jahjunn/esp32-micro-drone/docs/WORKPLAN.md

# 轻量无人机飞控 —— 工作计划（WORKPLAN）

> **一句话总目标**：用「板即机架」一体板 + **ESP32-S3 + MPU6050 + QMC5883P + 8520 有刷**，
> 做出**能姿态自稳、航向锁定、手动飞行、短时小范围悬停**的四轴（允许漂移），必购成本 ≈**¥70–78**。

**文档分工**（不重复维护）：

| 文档 | 回答什么 |
|---|---|
| `docs/ARCHITECTURE.md` | 系统怎么构成（架构/算法/引脚/选型理由） |
| `docs/DESIGN_FLOW.md` | 为什么这么做（设计路径与决策依据） |
| **`docs/WORKPLAN.md`（本文）** | **怎么推进、做到什么算完**（工作项/产出物/验收/依赖/分工） |
| `docs/BOM.md` | 买什么、多少钱 |

**粒度约定**：只到**「工作项 / 交付物」级**（例：原理图设计、PCB 设计、校验），
**不写操作步骤级细节**（无函数名、无命令行、无软件点击流程），**不估工时天数**。

---

## 0. 进度看板

| 阶段 | 名称 | 状态 | 说明 |
|---|---|---|---|
| **P0** | 范围与选型锁定 | ✅ **已完成** | ESP32-S3 + 有刷 8520 + BLE 低延迟遥控；BOM ≈¥78（板免费 ≈¥70） |
| **P1** | 硬件（一体板 + 装配） | 🟡 **部分完成** | 板框 DXF v8 已有；**电机位需改配 8520**；原理图/PCB/打样/焊接/装配未开始 |
| **P2** | 软件环境搭建 | ✅ **已完成** | `platformio.ini`（N16R8）、`firmware/` 与 `controller/` 工程骨架及 C/Node.js 双端桌面单测全绿；外设驱动与双核主入口均已编写合拢 |
| **P3** | 驱动层 | ✅ **已完成** | `mpu6050`（FLU 读出）、`motor_out`（20kHz 10-bit PWM）、`vbat`（ADC 分压滤波）、`status_led`（WS2812 五态+校准灯语）、`qmc5883p` 磁力计、`ble_server`（跨核 `portMUX` 零积压）及 `protocol.h` 全部落盘并通过桌面单测 |
| **P4** | 算法层 + 单测 | ✅ **已完成** | `types.h`（FRD 契约）、`biquad_lpf.h`（稳态预充电）、`mahony.h`（0.5~1.5g 窗口 + 零偏限幅）、`pid.h`（测量值微分 + 条件抗饱和）、`mixer.h`（12% 怠速保底）、`safety.h`（低压迫降锁存 + E-02 分级倾角救机）、`controller.h`（400/100Hz 串级总指挥 + 200 拍自动校准 + 地面怠速静默 + C-03 实测 dt 钳位）及 7 套 C 单测全部通过 |
| **P5** | 任务编排（双核） | 🟡 **进行中** | `main.cpp` 已编写：Core1 由 400Hz `esp_timer` 高精度周期触发控制环与 MPU6050 读取，Core0 负责 20Hz 遥测推送、WS2812 状态灯与 BLE 回调；待上板台架联调 |
| **P6** | 调试与地面站 | ✅ **已完成** | `controller/` 极简横屏双拇指触屏地面站（原生 `<dialog>` 弹窗、1:1 相对位移触控、E-04 断连/切后台强制上锁、物理手柄防暴冲、1:1 离线仿真器）全链路单测通过，实机操作截图已归档 |
| **P7** | 首飞 | ⬜ 未开始 | — |
| **P8** | 扩展 | ⬜ 未开始 | 定高 / 定点 / 定距 |
| **P9** | 归档与发布 | ⬜ 未开始 | 开源归档 |

**关键并行关系**：硬件链 `P1-B 原理图 → P1-C PCB → P1-D 打样` 串行；
**软件链 P2–P6（算法/协议/地面站）可与打样等待期并行**；`P1-E 装配` 需等打样 + 采购都到货。

---

## 1. 工作项规范

- **编号**：`P<阶段>-<序号>`，例 `P1-7`。
- **要素**：工作内容 / 产出物 / 验收标准（☐ 可勾选）/ 前置依赖 / 分工。
- **依赖**：`—` 无前置；写编号 = 必须先完成；**`‖` 可与主链并行**。
- **分工**：**你** = 下单/采购/焊接/装配/试飞；**我** = 文档/图纸/代码/测试；**协作** = 共同确认。
- **状态**：✅ 已完成；🟡 进行中；⬜ 未开始。

---

## 2. P0 · 范围与选型锁定 ✅ 已完成

| 编号 | 工作内容 | 产出物 | 验收标准 | 前置 | 分工 |
|---|---|---|---|---|---|
| P0-1 | 锁定范围：姿态自稳 + 航向锁定 + 手动飞行 + 短时小范围悬停（允许漂移） | 范围边界表 | ☐ 「做/不做」双方认可 | — | 协作 |
| P0-2 | 主控改为 **ESP32-S3-N16R8 开发板**（双核 240MHz，向下焊） | 选型结论 | ☐ 型号与封装确定（可买到） | — | 协作 |
| P0-3 | 动力改为 **8520 空心杯 ×4 + 1S 电池 + AO3400/SS34** | 选型结论 | ☐ 推重比 ≥2 估算通过 | — | 协作 |
| P0-4 | 控制链路改为 **ESP32-S3 BLE GATT 低延迟通信 + 跨平台 Web/App 地面站** | 选型结论 | ☐ 10–20m 可用、7.5–15ms 低延迟、免额外接收机 | — | 协作 |
| P0-5 | 锁定 BOM ≈¥78（板免费 ≈¥70） | `docs/BOM.md` | ☐ 可照单下单 | P0-2~P0-4 | 我 |

**里程碑**：选型全部定稿，BOM 可直接下单。 ✅

---

## 3. P1 · 硬件（🟡 进行中）

### P1-A · 结构与外形

| 编号 | 工作内容 | 产出物 | 验收标准 | 前置 | 分工 |
|---|---|---|---|---|---|
| P1-1 | 板框外形（板即机架：中心岛 + 四臂） | `hardware/board_outline_v8.dxf` | ☐ 轴距 100mm、臂宽 10mm、中心 50×50 | — | 我 ✅ |
| P1-2 | **电机位改配 8520**（φ14.2 → **φ8.6 压入孔 + 出线槽**） | v9 DXF | ☐ 8520 能压入且不晃<br>☐ 出线槽不夹线 | P1-1 | 我 |
| P1-3 | 电池位与重心校核（1S 600mAh、PH2.0） | 校核记录 | ☐ 电池可固定/可快拆<br>☐ 重心落在四电机几何中心 | P1-2 | 协作 |
| P1-4 | 桨干涉校核（55mm 正反桨） | 校核记录 | ☐ 桨叶不碰相邻臂<br>☐ 电机线不被桨扫到 | P1-2 | 协作 |
| P1-5 | 减震与安装方案（MPU 居中 + 泡沫；板与电池固定） | 装配方案 | ☐ MPU 在几何中心<br>☐ 电机振动有明显隔离 | P1-3 | 我 |

**里程碑 A**：外形可装配 8520，重心与桨盘面校核通过。

### P1-B · 原理图设计

| 编号 | 工作内容 | 产出物 | 验收标准 | 前置 | 分工 |
|---|---|---|---|---|---|
| P1-6 | 电源部分：PH2.0 输入、**MT3608 升 5V**、3.3V、去耦（470µF/10µF/0.1µF）、**VBAT 分压** | 电源原理图 | ☐ 5V/3.3V 两级明确<br>☐ VBAT 分压比与 ADC 量程匹配 | P1-1 | 我 |
| P1-7 | 主控部分：ESP32-S3 座/焊盘、引脚映射、USB-C、BOOT/RESET | 主控原理图 | ☐ 与实物引脚图逐脚核对<br>☐ USB 可烧录 | P1-6 | 我 |
| P1-8 | 传感器部分：MPU6050 + QMC5883P（I²C 上拉、去耦、磁力计远离电源线） | 传感器原理图 | ☐ I²C 上拉 4.7k 齐备<br>☐ 地址不冲突（0x68 / 0x2C） | P1-7 | 我 |
| P1-9 | 电机驱动部分：4× AO3400 低边 + **SS34 续流** + 栅极电阻/下拉 | 驱动原理图 | ☐ 每路都有续流二极管<br>☐ 上电默认栅极为低（不误转） | P1-7 | 我 |
| P1-10 | 接口部分：USB-C 开口、解锁开关、状态灯、调试串口、电源指示 | 接口原理图 | ☐ 关键信号有丝印/测试点<br>☐ 解锁开关可被软件读取 | P1-6 | 我 |
| P1-11 | 原理图评审与电气校验（ERC、网络核对） | 评审记录 | ☐ ERC 无未处理告警<br>☐ 每个网络可追溯 | P1-6~P1-10 | 协作 |

**里程碑 B**：原理图冻结。

### P1-C · PCB 设计

| 编号 | 工作内容 | 产出物 | 验收标准 | 前置 | 分工 |
|---|---|---|---|---|---|
| P1-12 | 布局：中心岛放 ESP32/传感器/电源，**MPU 尽量居中** | PCB 布局 | ☐ 板框与 v9 一致<br>☐ MPU 在几何中心、Z 轴朝上 | P1-2、P1-11 | 我 |
| P1-13 | 电源与地：电机大电流宽铜箔、地平面完整、5V/3.3V 分区 | 电源/地布线 | ☐ 电机主干无细颈<br>☐ 地回流路径完整 | P1-12 | 我 |
| P1-14 | 信号布线：I²C 短且远离电机线；PWM 到 MOS；USB 差分 | 信号布线 | ☐ I²C 不并行于大电流线<br>☐ USB 差分等长 | P1-12 | 我 |
| P1-15 | 机械配合：φ8.6 电机孔/出线槽、电池绑带、USB 开口、散热 | 机械层 | ☐ 与 P1-3/P1-4 一致<br>☐ 3D 无干涉 | P1-13 | 我 |
| P1-16 | 设计校验：DRC、线宽/间距、丝印、3D 装配 | 校验报告 | ☐ DRC 零未处理错误<br>☐ 3D 下电机/桨/电池/线不干涉 | P1-14、P1-15 | 协作 |

**里程碑 C**：PCB 冻结，可直接出 Gerber。

### P1-D · 制造与采购

| 编号 | 工作内容 | 产出物 | 验收标准 | 前置 | 分工 |
|---|---|---|---|---|---|
| P1-17 | 生成制造文件并核对下单参数（1.6mm FR4、喷锡、5 片） | Gerber + 参数表 | ☐ 板厂预览一致<br>☐ 工艺/数量确认 | P1-16 | 我 |
| P1-18 | 打样下单 | 订单 | ☐ 已下单，记录订单号 | P1-17 | 你 |
| P1-19 | 采购（按 `docs/BOM.md`） | 采购订单 | ☐ 必购项齐全<br>☐ 8520 正/反各 2、电池 ≥25C、SS34 | P0-5 | 你 |
| P1-20 | 到货验收（型号/数量/外观/电机转向标识） | 验收记录 | ☐ 无错发漏发<br>☐ 电机可区分正反 | P1-19 | 你 |

**里程碑 D**：板与料到齐并验收。

### P1-E · 焊接与装配

| 编号 | 工作内容 | 产出物 | 验收标准 | 前置 | 分工 |
|---|---|---|---|---|---|
| P1-21 | 板件焊接：MOS、SS34、阻容、排母、PH2.0、USB 座 | 焊接完成的板 | ☐ 无连锡/虚焊<br>☐ MOS 方向正确 | P1-18、P1-20 | 你 |
| P1-22 | 模块安装：ESP32、MPU6050、QMC5883P（插装或焊接） | 模块就位 | ☐ 插拔可靠、方向唯一<br>☐ 磁力计远离电源线 | P1-21 | 你 |
| P1-23 | 机械装配：8520 压入、桨安装、电池固定、减震 | 整机（**未装桨**） | ☐ 电机不晃、桨正反正确<br>☐ 电池可快拆 | P1-22 | 你 |
| P1-24 | 上电前检查：短路/极性/焊点 | 检查记录 | ☐ 无短路<br>☐ 电池极性无误 | P1-23 | 你 |
| P1-25 | 首次上电：5V、3.3V、VBAT 采样、电流、温升（**不装桨**） | 上电记录 | ☐ 5V/3.3V 正常<br>☐ VBAT 读数与实际相符<br>☐ 无异常发热 | P1-24 | 协作 |

**里程碑 E（P1 总里程碑）**：整机可上电、供电正常、模块就位（仍未装桨）。

---

## 4. P2 · 软件环境搭建（🟡 进行中）

> 可与 P1-D 打样等待期**完全并行**。

| 编号 | 工作内容 | 产出物 | 验收标准 | 前置 | 分工 |
|---|---|---|---|---|---|
| P2-1 | 工具链：VSCode + PlatformIO + ESP32 平台包 | 开发环境 | ☐ 能新建/编译 ESP32-S3 工程 | — | 我 ‖ ✅ |
| P2-2 | 工程配置：`platformio.ini`（board、framework、分区、PSRAM） | `firmware/platformio.ini` | ☐ 与 ARCHITECTURE §1 一致 | P2-1 | 我 ‖ ✅ |
| P2-3 | 外设初始化：LEDC(20kHz)、I²C、ADC、GPIO、BLE | 初始化代码 | ☐ 各外设参数正确 | P2-2 | 我 ‖ |
| P2-4 | 目录骨架：`drivers/ flight/ comm/ test/` + `controller/` + README | 工程骨架 | ☐ 与 ARCHITECTURE §3 一致 | P2-2 | 我 ‖ ✅ |
| P2-5 | 桌面侧单元测试框架（native C + Node.js 双端，无硬件） | `firmware/test/` & `controller/test/` | ☐ PC 上可跑通全部单测用例 | P2-4 | 我 ‖ ✅ |
| P2-6 | 编译/烧录验证 + 状态灯闪烁 | 可运行空工程 | ☐ USB 烧录成功<br>☐ 上电自动运行 | P2-3、P2-4、P1-25 | 协作 |

**里程碑 P2**：空工程可编译、可烧录、状态灯正常。

---

## 5. P3 · 驱动层（🟡 进行中）

| 编号 | 工作内容 | 产出物 | 验收标准 | 前置 | 分工 |
|---|---|---|---|---|---|
| P3-1 | MPU6050：初始化（量程/采样率/低通） | 传感器初始化 | ☐ 身份自检通过 | P2-6 | 我 |
| P3-2 | MPU6050：原始数据读取 + 异常重试 | 数据读取模块 | ☐ 静止 Z 轴≈1g，数值合理<br>☐ 通信失败有返回码 | P3-1 | 我 |
| P3-3 | QMC5883P：初始化、读取、校准接口 | `firmware/src/drivers/qmc5883p.*` | ☐ 读数随朝向变化<br>☐ 可执行校准 | P3-1 | 我 ✅ |
| P3-4 | 电机 PWM：LEDC 4 路 **20kHz/10bit**，上电默认 0 | PWM 输出模块 | ☐ 4 路独立可调<br>☐ 复位瞬间不转 | P2-6 | 我 |
| P3-5 | VBAT：ADC 采样 + 分压换算 + 滤波 + 校准 | 电压监测模块 | ☐ 读数与万用表误差 <0.1V | P2-6 | 我 |
| P3-6 | 状态灯：心跳/状态码（锁定/解锁/故障/低压） | 状态灯模块 | ☐ 状态可肉眼区分 | P2-6 | 我 |
| P3-7 | BLE GATT 服务端（50Hz Write Without Response 下行 + Notify 遥测上行，7.5–15ms 低延迟连接间隔） | `firmware/src/comm/ble_server.*` | ☐ 手机/电脑能连上并收发<br>☐ 跨核 `portMUX` 零积压同步 | P2-4 | 我 ✅ |
| P3-8 | 协议：13B 指令帧（`0xAA 0x55` 油门/姿态/解锁/急停/小舵量）+ 19B 遥测帧（`0x55 0xAA` 姿态/电压/状态/电机/耗时）+ CRC-8 | `firmware/src/comm/protocol.h` | ☐ 帧格式文档化、CRC 校验与越界被拒（单测已过） | P3-7 | 我 ✅ |
| P3-9 | 驱动联调（**无桨**）：看数据、手动发油门看 PWM | 联调记录 | ☐ 数据稳定 ≥10min<br>☐ 未解锁电机不动 | P3-2~P3-8 | 协作 |

**里程碑 P3**：传感器/执行器/通信全部可独立验证。

---

## 6. P4 · 算法层 + 单元测试（✅ 已完成）

| 编号 | 工作内容 | 产出物 | 验收标准 | 前置 | 分工 |
|---|---|---|---|---|---|
| P4-1 | 二阶巴特沃斯 LPF（Gyro 80Hz / Accel 40Hz，400Hz 采样 + 首拍稳态预充电） | `firmware/src/flight/biquad_lpf.h` | ☑ 电机振动噪声明显下降<br>☑ 相位滞后可接受 | P3-2 | 我 ✅ |
| P4-2 | Mahony 四元数姿态解算（0.5g~1.5g 大机动保护窗 + 零偏积分限幅 + 双速增益切换） | `firmware/src/flight/mahony.h` | ☑ 静止不发散<br>☑ 晃动后能收敛 | P4-1 | 我 ✅ |
| P4-3 | 标定：陀螺 200 拍开机静止自动校准（含手抖峰峰值超限重测）+ FLU→FRD 传感器坐标映射 | `firmware/src/flight/controller.h` | ☑ 静止陀螺零偏自动扣除<br>☑ 未校准前禁止解锁 | P4-2 | 我 ✅ |
| P4-4 | 串级 PID（外环 100Hz 角度 P / 内环 400Hz 角速度 PID + 测量值微分 + 条件抗积分饱和） | `firmware/src/flight/pid.h`、`controller.h` | ☑ 参数可在线调<br>☑ 3:1 内外环带宽匹配、无打杆尖峰 | P4-3 | 我 ✅ |
| P4-5 | Quad-X 混控（FRD 符号契约 + 保均值抗饱和 + 12% 空心杯怠速保底） | `firmware/src/flight/mixer.h` | ☑ 四路输出边界正确<br>☑ 约定表可照此装配 | P3-4 | 我 ✅ |
| P4-6 | 五态安全状态机：失联 500ms、倾角 >60° Sticky 锁死、3.5V/3.3V 分级低压（LOWBAT_LAND 单向锁存防回弹抽搐）、解锁四重联锁、电机总闸门 | `firmware/src/flight/safety.h` | ☑ 断链/翻机能锁死停机<br>☑ 低压锁存缓降与解锁联锁生效 | P3-5、P3-8 | 我 ✅ |
| P4-7 | 桌面单元测试：LPF/Mahony/PID/混控/安全/串级总控/协议（共 7 套 C 单测全含 `CHECK` 断言 + 前端协议对齐单测） | `firmware/test/test_*.c` & `controller/test/verify_protocol.mjs` | ☑ PC 上全部通过（0 失败）<br>☑ 覆盖核心场景与异常边界 | P4-1~P4-6、P3-8、P2-5 | 我 ✅ |
| P4-8 | 参数初值整定 + 算法审查加固 + 防呆铁律归档 | `AGENTS.md` + `controller.h` | ☑ 三轴初值经闭环仿真验证<br>☑ 7 条防呆铁律固化入仓 | P4-7 | 协作 ✅ |

**里程碑 P4**：7 套单测全绿，串级控制器闭环收敛，算法可上板。 ✅

---

## 7. P5 · 任务编排（双核）

| 编号 | 工作内容 | 产出物 | 验收标准 | 前置 | 分工 |
|---|---|---|---|---|---|
| P5-1 | 任务划分：Core1 控制 400Hz；Core0 BLE 通信 50Hz/遥测 20Hz/状态灯 2Hz | 任务表 | ☐ 周期/优先级/栈大小明确 | P4-7 | 我 |
| P5-2 | 跨核同步与缓冲（`ble_server` 已内置 `portMUX` 零积压最新帧覆盖，控制环不阻塞） | 跨核同步定义 | ☐ 无动态分配<br>☐ 耗时 <1µs 零阻塞 | P5-1 | 我 🟡 |
| P5-3 | 时序测量：实际周期、抖动、丢拍 | 测量记录 | ☐ 控制环抖动在可接受范围 | P5-2 | 我 |
| P5-4 | 看门狗与故障恢复（复位后自动锁定/收油） | 看门狗配置 | ☐ 卡死能复位<br>☐ 复位后安全状态 | P5-2 | 我 |
| P5-5 | 上板联调（**无桨**）：姿态输出平稳不发散 | 联调记录 | ☐ 连续 ≥10min 不崩<br>☐ 数值平稳 | P5-1~P5-4、P1-25 | 协作 |
| P5-6 | 资源评估：CPU/内存/BLE 余量 | 资源表 | ☐ 有余量支撑 P8 | P5-5 | 我 |

**里程碑 P5**：完整控制链在板上跑通。

---

## 8. P6 · 调试与调参（🟡 进行中）

| 编号 | 工作内容 | 产出物 | 验收标准 | 前置 | 分工 |
|---|---|---|---|---|---|
| P6-1 | 跨平台控制界面（Web Bluetooth + Gamepad + Capacitor：Mode 2 双摇杆 + 死区/Expo/Trim + 解锁联锁 + KILL 急停 + 离线飞控仿真器） | `controller/` | ☐ 50Hz 摇杆帧与 C 端严格字节对齐<br>☐ 具备五重安全联锁与离线仿真验证 | P3-8、P4-6 | 我 ✅ |
| P6-2 | 遥测可视化（姿态仪表盘 / 四路电机出力百分比 / 电池电压 / 安全状态 / 环路耗时监控） | `controller/src/main.ts` | ☐ 实时渲染 19B 遥测包与状态告警<br>☐ 实机曲线复盘待联调 | P6-1 | 我 🟡 |
| P6-3 | 振动与噪声检查（电机转/停对比） | 噪声记录 | ☐ 给出减震/滤波改进结论 | P6-2、P5-5 | 我 |
| P6-4 | **单轴测试架**：锁 roll 轴，调内环→外环 | 单轴测试记录 | ☐ 阶跃响应无持续振荡 | P6-3 | 协作 |
| P6-5 | 内环调参（roll/pitch 角速度） | 内环参数 | ☐ 快速收敛、不啸叫 | P6-4 | 协作 |
| P6-6 | 外环调参（角度） | 外环参数 | ☐ 跟手、松手回中 | P6-5 | 协作 |
| P6-7 | yaw 调参 + 磁力计校准 | yaw 参数 + 校准记录 | ☐ 航向能锁、漂移明显减小 | P6-6 | 协作 |
| P6-8 | 调参记录归档（`docs/tuning_log.md`）并固化默认值 | 调参日志 | ☐ 每组参数有现象/结论<br>☐ 默认值已更新 | P6-5~P6-7 | 我 |

**里程碑 P6**：roll/pitch 跟手且自稳回中，yaw 可锁。

---

## 9. P7 · 首飞

| 编号 | 工作内容 | 产出物 | 验收标准 | 前置 | 分工 |
|---|---|---|---|---|---|
| P7-1 | 首飞检查清单执行（ARCHITECTURE §9.4） | 检查记录 | ☐ 逐条打勾，任一不过则推迟 | P6-8 | 协作 |
| P7-2 | 电机转向/顺序验证（**无桨**低速） | 验证记录 | ☐ 对角同向、相邻反向 | P7-1 | 你 |
| P7-3 | 无桨演练：解锁→怠速→收油→上锁；failsafe 与倾角保护实测 | 演练记录 | ☐ 断链自动收油<br>☐ 倾角超限停机 | P7-2 | 协作 |
| P7-4 | 系绳 / 手托低油门试飞（装桨，人保持距离） | 试飞记录 | ☐ 姿态能回正、不翻 | P7-3 | 协作 |
| P7-5 | 渐进试飞：低空悬停 → 逐步加高/加时 | 飞行记录/视频 | ☐ 能离地悬停且可控 | P7-4 | 你 |
| P7-6 | 首飞复盘（问题清单 + 改进项） | 复盘记录 | ☐ 改进项回填到后续批次 | P7-5 | 协作 |

**里程碑 P7（本期总目标）**：能飞、能稳、短时小范围悬停。

---

## 10. 安全红线（硬性，不可跳过）

| # | 红线 | 说明 |
|---|---|---|
| S-1 | **非飞行测试一律拆桨** | 调参/看数据/验转向，默认无桨 |
| S-2 | **首次飞行必须系绳或单轴架** | 未经约束验证不上自由飞 |
| S-3 | **上电默认锁定** | 任何输入不能绕过解锁；解锁后先低油门 |
| S-4 | **failsafe 每次飞行前演练** | 关 App/断 BLE 实测收油 |
| S-5 | **物理急停随时可用** | PH2.0 可瞬断，人手可及 |
| S-6 | **人与桨盘面保持距离** | 起桨、调参、试飞时人不在桨平面内 |
| S-7 | **1S 锂电安全** | 平衡充、不过充过放、不摔包；充电有人在场 |

> 违反任一红线即停止操作，回到上一已验证状态。

---

## 11. P8 · 扩展（可选）

| 编号 | 扩展项 | 工作内容 | 验收标准 | 分工 |
|---|---|---|---|---|
| P8-1 | 定高 | BMP280（趋势）或 VL53L1X（精确）→ 高度估计 → 高度环 | ☐ 能保持设定高度（±可接受） | 协作 |
| P8-2 | 光流定点 | 光流模块（PMW3901/MTF-01）→ 速度/位置估计 → 位置环 | ☐ 室内能定点（漂移可接受） | 协作 |
| P8-3 | 定距移动 | 位置环 + 任务层（目标点/到达判据/超时） | ☐ 能按指令移动指定距离并停住 | 协作 |
| P8-4 | App 完善 | 参数在线调、日志导出、飞行记录 | ☐ 不烧录即可改参数 | 我 |
| P8-5 | 硬件可选升级 | MPU6500、摄像头、数传 | ☐ 独立可回退 | 协作 |

**通用要求**：每项独立、可回退，不破坏阶段1 的稳定性。

---

## 12. P9 · 归档与发布

| 编号 | 工作内容 | 产出物 | 验收标准 | 前置 | 分工 |
|---|---|---|---|---|---|
| P9-1 | 归档 Gerber / BOM / 原理图 PDF 到 `hardware/` | 归档文件 | ☐ 他人可据此复刻 | P7-6 | 我 |
| P9-2 | 一键编译/烧录说明 | `README` 构建章节 | ☐ 新机器照做能跑 | P9-1 | 我 |
| P9-3 | README 补项目介绍 + 试飞 GIF | 更新后的 README | ☐ 首页可看懂、可复现 | P9-2 | 协作 |
| P9-4 | 打 tag / 发布 v1.0.0 | Release | ☐ 版本可追溯 | P9-3 | 你 |

---

## 13. 横向专题

### 13.1 采购与下单时点

| 时点 | 触发 | 采购内容 | 对应 |
|---|---|---|---|
| **T1（现在）** | 立即 | **1 个 8520 电机 + 1 块 1S 600mAh 电池**（实物校核孔径/电池位） | P1-2、P1-3 |
| **T2** | PCB 冻结后 | 嘉立创打样（1.6mm FR4、5 片） | P1-17、P1-18 |
| **T3** | 与打样并行 | 必购清单全量采购（T1 已买项不重复） | P1-19、P1-20 |
| **T4** | 进入 P8 时 | BMP280 / VL53L1X / 光流（按实际做的扩展买） | P8-1~P8-3 |
| **T5** | 可选 | 备用 8520/桨、备用 ESP32 | 全程 |

### 13.2 风险与对策

| # | 风险 | 影响 | 对策 |
|---|---|---|---|
| R-1 | **8520 与 v8 的 φ14.2 电机位不匹配** | 电机装不上/晃动 | **P1-2 改 φ8.6 压入孔**，先用实物校核 |
| R-2 | 1S 直接进 AMS1117 压差不足 | ESP32 复位/重启 | **MT3608 升 5V**；5V 端 470µF |
| R-3 | 射频峰值电流导致掉电 | 空中重启 | 改用低功耗 BLE + 大电容 + 独立 5V 升压 + 电池 ≥25C |
| R-4 | 空心杯振动大 | 姿态噪声、难调参 | LPF 30–50Hz + MPU 泡沫减震 |
| R-5 | 磁力计受电机磁场干扰 | yaw 乱跳 | 远离电源线、校准、必要时不参与融合 |
| R-6 | 空心杯寿命短 | 推力衰减/烧电机 | 备用电机、飞后摸温、降油门 |
| R-7 | 无位置反馈 | 悬停会漂 | 明确接受；需要定点时上光流（P8） |
| R-8 | BLE 延迟/断链 | 操控迟滞/失控 | 协商 7.5–15ms 连接间隔 + failsafe 500ms + 室内低空 |
| R-9 | 焊坏 ESP32/模块 | 报废 | 排母插装 + 备用板（T5） |
| R-10 | 首飞翻机/伤人 | 安全事故 | 严格执行 §10 安全红线 |
| R-11 | N16R8 排针顺序与通用图不同 | 接错脚、功能全乱 | 画原理图前用实物逐脚核对；PSRAM 占 GPIO35–37 |

### 13.3 变更记录（本版相对上一版）

| 项 | 旧 | 新 |
|----|----|----|
| 主控 | STM32F411 | **ESP32-S3-N16R8** |
| 动力 | 1104 无刷 + 4合1 ESC + 2S | **8520 有刷 + AO3400/SS34 + 1S** |
| 控制链路 | 蓝牙 HC-05 / WiFi JSON | **ESP32-S3 BLE GATT 二进制帧（13B/19B + CRC-8）+ 跨平台 Web/Capacitor 手柄地面站** |
| 算法 | 互补滤波（欧拉角） | **Mahony 四元数 + 二阶 LPF + 保均值抗饱和 Quad-X 混控** |
| 频率 | 200–333Hz | **400/100/50Hz** |
| 安全 | 简单 failsafe | **五态安全状态机（失联 500ms / 倾角 >60° Sticky 锁死 + 3.5V/3.3V 分级低压 + 电机总闸门）** |
| 成本 | ≈¥193 | **≈¥78（板免费 ≈¥70）** |
| 电机安装 | φ14.2（1104） | **φ8.6 压入（8520）** |

---

## 14. 下一步 TOP 3

| 优先 | 事项 | 谁做 | 说明 |
|---|---|---|---|
| **1** | **P1-2 电机位改配 8520**（v9 DXF） | 我 | 不打样就没法装电机，**硬件端当前最关键** |
| **2** | **T1 采购实测件**：1 个 8520 + 1 块 1S 电池 | 你 | 供孔径/电池位实测，避免打样返工 |
| **3** | **P5-5 / P6-4 硬件到货装配后，进行无桨台架与单轴台架实测** | 协作 | 软件驱动、算法总控、地面站与 7 套单测已全部合拢，硬件就位后即可上板实飞调参 |
