jahjunn/esp32-micro-drone/docs/BOM.md

# BOM 清单 —— ESP32 + 有刷 8520 方案

> 目标：**ESP32-S3-N16R8 + MPU6050 + QMC5883P + 8520 空心杯**，BLE 低延迟手机/手柄控制；
> 能力：姿态自稳、航向锁定、短时小范围悬停。
> 价格随渠道浮动 ±20% 正常。

## 1. 必购

| # | 部件 | 型号 / 规格 | 单价(¥) | 数量 | 小计(¥) | 备注 |
|---|---|---|---|---|---|---|
| 1 | 主控 | **ESP32-S3-N16R8 开发板**（双核 240MHz，16MB Flash / 8MB PSRAM，USB-C，向下焊） | 24.25 | 1 | 24.25 | 25.5×52.5mm；向下焊可直接贴装 |
| 2 | 姿态传感器 | **MPU6050 GY-521**（I²C） | 6 | 1 | 6 | 可平替 MPU6500 |
| 3 | 磁力计 | **QMC5883P**（I²C 0x2C） | 3 | 1 | 3 | 航向锁定；丝印确认 P 版 |
| 4 | 电机 | **8520 空心杯**（3.7V，有刷） | 3 | 4 | 12 | 红蓝=正转，黑白=反转 |
| 5 | 螺旋桨 | **55mm 正反桨** | 0.75 | 4 | 3 | 2 正 + 2 反 |
| 6 | 电机开关 | **AO3400**（N-MOS，SOT-23） | 0.25 | 4 | 1 | 低边驱动 |
| 7 | 续流二极管 | **SS34**（肖特基 3A） | 0.25 | 4 | 1 | **别用 SS14(1A)**，8520 堵转约 4A |
| 8 | 电池 | **1S 3.7V 600mAh ≥25C**，PH2.0 | 12 | 1 | 12 | 悬停约 4–5A |
| 9 | 升压 | **MT3608 模块**（1S→5V） | 3 | 1 | 3 | 给 ESP32 供电 |
| 10 | 机架 / PCB | **嘉立创异形板**（板即机架，100mm 轴距） | 8 | 1 | 8 | 打样券可 ¥0 |
| 11 | 阻容 / 接插件 | 0603 电阻电容、排母、PH2.0、拨动开关 | 5 | 1 | 5 | 含 470µF/10µF/0.1µF |
| | | | | **合计** | **78** | 板免费则 **70** |

## 2. 工具与耗材（可复用，不计入必购）

| 部件 | 说明 | 参考价(¥) |
|---|---|---|
| 1S USB 充电器 | 若已有则省 | ~12 |
| 烙铁 + 焊锡 + 助焊剂 | 焊 MOS / 阻容 / 接线 | 已有 |
| 万用表 | 测电压 / 通断 | 已有 |
| 系绳 / 单轴测试架 | 首次试飞与调参安全用，可自制 | 0 |

## 3. 选配（想升级再加）

| 部件 | 型号 | 单价(¥) | 用途 |
|---|---|---|---|
| 气压计 | BMP280 | ~8 | 高度趋势（漂移大，仅参考） |
| 激光测距 | VL53L1X | ~25 | 精确定高（0.05–4m） |
| 光流 | PMW3901 / MTF-01 | ~70–150 | 定点 / 定距移动（需加位置环） |
| 备用电机 + 桨 | 8520 ×2 + 55mm ×4 | ~15 | 空心杯寿命短，建议备 |
| 备用主控 | ESP32-S3-N16R8 | ~24 | 防焊坏 |

## 4. 关键说明

- **供电必须升压**：1S 3.7V 直接进 AMS1117-3.3 压差不够（需 ≥4.4V），要 **MT3608 升到 5V** 再进 ESP32 的 5V/板载 LDO。
- **PWM 是 20kHz**（LEDC），**不是舵机 50Hz**；有刷电机用高频 PWM 才不啸叫、不抖。
- **引脚以实物为准**：N16R8 开发板不同厂家排布不同；**PSRAM 占用 GPIO35–37**，不要使用。
- **磁力计地址**：QMC5883P 是 **0x2C**（不是 QMC5883L 的 0x0D）。**L 版库不能用**，必须按 P 版寄存器映射；收货先扫 I²C 地址确认 = 0x2C。
- **电机安装**：8520 本体约 φ8.5mm，需 **φ8.6 压入孔 + 出线槽**；现有 v8 板框的 φ14.2 电机位是按更大外径画的，**要改**（见 WORKPLAN P1-2）。
- **尺寸**：N16R8 约 25.5×52.5mm，比 50×50 中心岛每边探出约 1.25mm，可接受；若想完全包住，把中心岛放大到 54×54。
- **安全必做**：失联 500ms 收油、倾角 >60° 停机、低电报警、解锁逻辑、物理急停（拔电）。
- 空心杯**寿命有限**（几十小时），飞行后摸电机是否发烫，发烫即降油门或换电机。

## 5. 引脚速查（ESP32-S3-N16R8，**以实物丝印为准**）

| 信号 | GPIO | 外设 |
|---|---|---|
| I²C SDA | GPIO8 | MPU6050 + QMC5883P |
| I²C SCL | GPIO9 | 同上 |
| M1 右前 | GPIO1 | LEDC CH0（20kHz） |
| M2 右后 | GPIO2 | LEDC CH1 |
| M3 左后 | GPIO3 | LEDC CH2 |
| M4 左前 | GPIO4 | LEDC CH3 |
| VBAT | GPIO5 | ADC1_CH4（100k/100k 分压） |
| 解锁开关 | GPIO10 | 拨动开关（可选，App 也可解锁） |
| 状态灯 | GPIO48 | 板载 RGB（若未引出则用外接 LED） |
| USB | GPIO19/20 | 原生 USB，**勿占用** |
| 串口调试 | GPIO43/44 | USB 串口（UART0） |
| **禁用** | GPIO35–37 | **PSRAM 占用** |

> 画原理图前，必须拿实物逐脚核对：GPIO 编号 ≠ 排针物理序号。
