jahjunn/esp32-micro-drone/(list of files, cad)

Other CAD files:
hardware/board_outline_v8.dxf
hardware/board_outline_v6.dxf
hardware/board_outline_v1.dxf
hardware/board_outline_v3.dxf
hardware/board_outline_v2.dxf
hardware/board_outline_v4.dxf
hardware/board_outline_v5.dxf
