jahjunn/esp32-micro-drone/docs/ERRATA.md

# 纠错清单（ERRATA / 修复进度台账）

> **用途**：把每一次代码复核发现的问题固化下来，下次复核时**逐条勾选**，形成可追踪的修复进度。
> **怎么维护**：查出问题 → 在 §2 主表加一行（分配新 ID）→ §3 写详情与验收标准 → 修好后把状态改成 ✅ 并补证据 → 复核通过后移到 §4 归档 → §7 追加一行变更记录。
> **最近复核**：2026-11-07（第 2 轮）　**基线**：`acc5dd9`　**复核范围**：全仓（firmware / controller / docs）

---

## 0. 使用约定

### 0.1 状态图例

| 图标 | 含义 | 谁来改 |
|:---:|---|---|
| ⬜ | 已确认，未动工 | — |
| 🟨 | 部分修复 / 修了但缺验收 | 修复者 |
| ✅ | 代码已改，**待复核** | 修复者 |
| ✔ | 复核通过，已归档 | 复核者 |
| ⛔ | 判定不修（附理由） | 复核者 |

### 0.2 「修好了」的判定标准（三条全满足才算 ✅）

1. **代码改对了** —— 不是绕过去，也不是改测试迁就代码；
2. **有断言兜底** —— 至少一条 `CHECK()` 会在旧代码上失败、在新代码上通过；
3. **在干净环境跑过** —— 删掉编译产物重新编译，全绿，且失败时退出码非 0。

> 只满足第 1 条的，状态一律记 🟨，不算完成。这条规则就是防「假绿灯」。

### 0.3 级别定义

| 级别 | 含义 |
|:---:|---|
| **P0** | 会让飞机摔掉、飞丢，或者根本飞不起来 |
| **P1** | 首飞前必须解决，否则现场必然踩坑 |
| **P2** | 首飞后优化，不影响安全性 |
| **P3** | 文档 / 可读性 |

---

## 1. 总览

| 统计项 | 数量 |
|---|---|
| 待修总计（未进 §4 归档） | **11**（其中 `✅待复核` 9 / `🟨进行中` 0 / `⬜未动工` 2） |
| 已闭环归档 | 9 |
| 判定不修 | 1 |
| 其中通过「有断言」验收的 | 8 / 9（仅 R4 靠配置检查，无断言） |

**当前阻断项**：全部 7 套 C 算法单测、2 套 Node 地面站单测与 ESP32-S3 PlatformIO 固件构建（`firmware.bin`）均已 100% 编译通过（`E-07`/`E-03`/`C-03` 全面转 ✅）；无代码级阻断项，待硬件打样焊接后上板烧录与拆桨台架联调。

---

## 2. 待修主表

> 按级别排序。下次复核时**只改「状态」列**，不动其他列，便于 diff。

| ID | 级别 | 问题（一句话） | 位置 | 状态 | 首次记录 |
|:---:|:---:|---|---|:---:|:---:|
| E-01 | **P0** | 偏航杆输入无人读取，打偏航电机无差动 | `controller.h:85,300` | ✅ | 11-07 |
| E-02 | **P0** | 倾角 >60° 立即断电机 → 本可救回的姿态直接坠机 | `safety.h:94-96,122` | ✅ | 11-07 |
| E-07 | **P0** | 无 `main.cpp` / `config.h` / MPU6050 驱动，控制器无硬件入口 | `firmware/src/` | ✅ | 11-07 |
| E-03 | P1 | 陀螺校准单窗口微振过于严苛 + 缺少校准状态可见性 | `controller.h:148-176` | ✅ | 11-07 |
| E-04 | P1 | 手柄断连/切后台只回中弹簧轴，不 disarm，油门轴不归零 | `main.ts` / `flight_logic.ts` | ✅ | 11-07 |
| E-05 | P2 | 怠速→飞行存在占空比阶跃；5% 分界点不连续 | `controller.h:267-272,306` | ✅ | 11-07 |
| E-06 | P2 | 满油门时四路同时顶满，姿态权限归零 | `controller.h` / `mixer.h` | ✅ | 11-07 |
| C-01 | P2 | 磁力计驱动已写但暂未接入融合，阶段1为偏航角速度保持 | `mahony.h` / `qmc5883p.cpp` | ⬜ | 11-06 |
| C-02 | P2 | PID 的 `output_limit` 固定，不随混控余量收紧 | `controller.h:279-302` | ⬜ | 11-06 |
| C-03 | P2 | 内环 `dt` 固定 0.0025，上板后需实测循环 `dt` 并钳位 | `controller.h` / `main.cpp` | ✅ | 11-06 |
| C-04 | P3 | 头文件统一补齐物理单位注释（rad/s、rad、[0,1]、[g]） | 全 `flight/*.h` | ✅ | 11-06 |

---

## 3. 待修详情

### E-01　偏航杆完全不生效　P0
- **根因**：`controller.h` 外环计算后遗漏 `fc->desired_rate.z = cmd.yaw_rate_target;`，导致 `desired_rate.z` 恒为 `0`。
- **修法**：恢复 `fc->desired_rate.z = cmd.yaw_rate_target;`，并在 `test_controller.c` 补齐四通道（Throttle / Roll / Pitch / Yaw）端到端差动断言。
- **进度**：✅ 已改并编译运行全绿（`test_controller.exe` 断言 `5a/5b` 通过）。

### E-02　倾角 >60° 立即切电　P0
- **根因**：瞬时阵风吹过 `60°` 与真倒扣（`>110°`）或持续失控未区分，第 1 拍直接切电导致本可自稳救回的姿态直接坠机。
- **修法**：基于三维投影 `cos_tilt = cosf(roll) * cosf(pitch)`（消除仰角万向锁盲区并防 NaN）做分级保护——`>110°`（倒扣）及地面怠速（`≤5%`）翻倒单拍立即 `FAILSAFE`；飞行中（`>5%`）处于 `>60°` 时归零摇杆目标并将油门上限压至 `45%`（`mix=0.40` 匹配内环满额纠偏力矩且≈悬停推力，显著减少低空掉高，保留 `LOWBAT_LAND` 25% 覆盖锁存），滞回退出角设 `45°` 防撞墙反弹清零计时，连续 `0.8s`（320 拍）未回到 `≤45°` 则判定失控切入 `FAILSAFE`。
- **进度**：✅ 代码与 `test_safety.c`（含 `9a~9f` 与 `5c`）已于本机清理重编（`test_safety.exe`）并全绿通过，待最终复核归档。

### E-03　陀螺仪校准容差与状态提示　P1
- **根因**：`0.15 rad/s` 峰峰值在桌面风扇微振下易反复清零，且未向遥测暴露“正在校准”状态（注：**严禁在手晃未校准通过时超时强行解锁起飞**，必须保证安全底线）。
- **修法**：将静止峰峰值容差调整至合理桌面阈值（`0.25 rad/s`），并在安全/遥测状态或校准标志中提供明确可观测性。
- **进度**：✅ `controller.h` 已放宽容差至 `0.25f` 并提供 `controller_is_calibrating()` 查询接口；已集成至 `status_led`（青蓝快闪）与 19B 遥测帧，且随 `firmware/` 完成 PlatformIO 一键构建全绿通过。

### E-04　手柄断连 / 切后台不上锁 + 前端 FRD/仿真器对齐　P1
- **根因**：`visibilitychange`、`blur`、`gamepaddisconnected` 仅回中弹簧轴，未强制 `disarm` 与归零油门；同时复核发现地面站还存在三处高危隐蔽缺陷：① 右杆前推/`▲ 前微调` 直传正值 `pitch = +1000` 与固件 FRD（`+Pitch=抬头`）符号相反导致前推反飞；② Xbox 弹簧左摇杆在 `50%` 居中死区跳过更新导致悬停段油门卡死跳跃；③ `ble_adapter.ts` 离线仿真器仍沿用旧版混控符号与立即 >60° 切电，且缺少 `LOWBAT_LAND` 单向锁存。
- **修法**：抽离零 DOM 依赖的 `controller/src/flight_logic.ts`——统一 `visibilitychange`/`blur`/`pagehide`/`gamepad-disconnect`（含 `GamepadPoller` 掉线下降沿）与 `ble-disconnect` 的强制 `disarm` + 油门归零 + `KILL` 急停包；将 Mode-2 前推与 `▲ 前微调` 映射为 FRD 负俯仰；补齐增量油门与直映 Soft-Takeover 防暴冲；将 `QuadSimulator` 与新版 `mixer.h`/`safety.h`（E-02/§6）1:1 对齐。
- **进度**：✅ 已完成重构，`verify_protocol.mjs`（4 项）与 `verify_controller.mjs`（6 大组全链路断言，含 `stripTypeScriptTypes`）均在 Node 24 实测全绿通过。

### E-05 & E-06　怠速→飞行连续衔接与满油门姿态余量　P2
- **根因**：`throttle = 0.05` 怠速输出 `0.12`，`0.06` 跳变至 `0.1728`；`throttle = 1.0` 时无姿态差动余量。
- **修法**：将飞行区间 `(0.05, 1.0]` 平滑线性映射至混控输入 `(0.0, 0.95]`，使 `0.05` 处精确衔接 `0.12` 零阶跃，同时在 `1.0` 满杆时保留 `5%` 混控余量供三轴纠偏。
- **进度**：✅ 已改并编译运行全绿（`test_controller.exe` 断言 `6`、`7` 通过）。

### E-07　硬件驱动与 `main.cpp` 上板集成　P0
- **范围**：新增 `config.h`、`drivers/mpu6050.*`、`drivers/motor_out.*`、`drivers/vbat.*`、`drivers/status_led.*` 与双核调度入口 `main.cpp`（`Core1` 由 400Hz `esp_timer` 触发控制 + I2C、`Core0` BLE + 20Hz 遥测 + LED）。
- **进度**：✅ 代码落盘并由用户执行 `pio run -d firmware` 编译成功，生成 `firmware.bin` 镜像（RAM 14.0%，Flash 14.9%）；待硬件到货台架烧录实测。
- **验收标准**：`pio run` 编译通过；拆桨台架实测姿态与 BLE 回传平稳对齐真实倾斜方向。

### C-01 ~ C-04　后续结构优化清单　P2/P3
- **C-01（航向观测，P2）**：`qmc5883p.cpp` 暂未接入 `mahony_update_imu()`，阶段 1 定位于偏航角速度保持，后续阶段补齐磁力计 9 轴融合并核实文档表述。
- **C-02（动态混控余量，P2）**：大机动时内环 `pid.output_limit` 宜结合油门与差动余量动态收紧，进一步抑制极端饱和反冲。
- **C-03（实测循环 `dt`，P2）**：✅ `controller_step_dt()` 已通过 `test_controller.exe` 桌面断言；`main.cpp` 基于 `esp_timer_get_time()` 的实测采集（钳位至 `[0.5, 1.5] × CTRL_DT`）已随 `pio run` 编译通过生成固件。
- **C-04（物理单位注释，P3）**：✅ 已统一在 `types.h`、`biquad_lpf.h`、`mahony.h`、`pid.h`、`mixer.h`、`safety.h`、`controller.h` 补齐 `[rad/s]`、`[rad]`、`[g]`、`[V]`、`[0.0, 1.0]` 等物理单位注释，且 7 套 C 单测 `-Wall -Wextra` 清理重编零警告全绿通过。

---

## 4. 已闭环归档

| 编号 | 原问题 | 闭环方式 | 证据 | 日期 |
|:---:|---|---|---|---|
| A1-1 | 无级联环，全局只有一个通用 PID | 新增 `controller.h`：外环 100 Hz 角度 P / 内环 400 Hz 角速度 PID | 311 行总控 + `test_controller.c` | 11-07 |
| A1-2 | 无电机怠速，混控下限 0 | `mixer_apply_idle()` + `MOTOR_IDLE_DEFAULT = 0.12` | `test_mixer.c` 断言四路 ≥ 0.12 | 11-07 |
| A1-3 | 无陀螺零偏标定（靠 ki 自学，τ≈200 s） | `controller.h` 200 拍静止采样 + 未校准禁止解锁 | 零偏误差 < 1e-5 | 11-07 |
| A2-1 | Mahony 无重力窗、积分无界 | 0.5–1.5 g 窗 + ±0.10 rad/s 限幅 + 窗外持续补偿 | 四姿态真值收敛误差 < 0.01° | 11-07 |
| A2-2 | PID 的 D 对误差求导，打杆出尖峰 | 改为测量值微分 + `has_prev` 保护 + 条件抗积分风up | 首拍 −20.0 精确、阶跃 D = 0 | 11-07 |
| A2-3 | LPF 写了但无人调用，加计裸奔 | 陀螺 80 Hz / 加计 40 Hz + 首拍 `biquad_reset_to` 预充电 | 直流增益 1.00000、150 Hz 残余衰减 | 11-07 |
| A3-1 | 5 个测试是假绿灯，永远 exit 0 | 7 套全部带 `CHECK` 宏，失败返回 1 | 全部断言 PASS | 11-07 |
| A3-2 | `types.h` 与 `mixer.h` 符号矛盾 | 统一到 AGENTS.md 的 FRD 契约 | 三轴符号逐一实测符合 | 11-07 |
| R4 | `platform = espressif32` 未锁版本 | 锁定 `espressif32@6.9.0`（core 2.0.17） | `platformio.ini:6` | 11-07 |
| — | 失联 500 ms 对 BLE 太短 | **判定不修**：上行 50 Hz，500 ms = 丢 25 帧，确实该停 | 理由记录，不改代码 | 11-07 |

---

## 5. 复核命令（每次改完跑一遍，PowerShell 5.1）

```powershell
New-Item -ItemType Directory -Force firmware/test/output | Out-Null
foreach ($t in @("biquad_lpf", "mahony", "pid", "mixer", "safety", "controller", "protocol")) {
  Remove-Item "firmware/test/output/test_$t.exe" -ErrorAction SilentlyContinue
  gcc -O2 -std=c11 -Wall -Wextra -Werror=return-type "firmware/test/test_$t.c" -lm -o "firmware/test/output/test_$t.exe"
  if ($LASTEXITCODE -ne 0) { Write-Error "BUILD_FAIL: $t"; break }
  & ".\firmware\test\output\test_$t.exe"
  if ($LASTEXITCODE -ne 0) { Write-Error "TEST_FAIL: $t"; break }
}
D:\Nodejs\node.exe controller/test/verify_protocol.mjs
D:\Nodejs\node.exe controller/test/verify_controller.mjs
```

> `firmware/test/output/` 与 `*.exe` 不应提交至 git。

---

## 6. 评分趋势（历史基线留档）

| 维度 | 11-06（第 1 轮） | 11-07（第 2 轮） | 说明 |
|---|:---:|:---:|---|
| 需求定义 | 9.0 | 9.0 | — |
| 硬件 | 2.0 | 2.0 | 板框 v8 仍待改 φ8.6 8520 孔位 |
| 固件算法 | 7.0 | 8.5 | 串级 + 标定 + 怠速 + 分级救机补齐中 |
| 固件集成 | 0.5 | 0.5 | 待 `E-07` 上板集成 |
| 地面站 | 6.5 | 6.5 → 升级中 | Step 3 完成 `E-04`、FRD 映射与防暴冲重构 |
| 测试 | 3.0 | 7.0 | 假绿灯 → 真断言 + Node 全链路单测 |
| 文档 | 8.0 | 8.0 | 合并重复清单，统一维护 `docs/ERRATA.md` |
| 工程化 | 3.0 | 4.0 | 版本锁定 + `AGENTS.md` 铁律持续更新 |
| **综合** | **4.7** | **6.8** | — |

---

## 7. 变更记录

| 日期 | 轮次 | 动作 | 执行者 |
|:---:|---:|---|---|
| 11-06 | 1 | 首轮全仓审查 | AI |
| 11-07 | 2 | 二次复核：关闭 9 条、建立 `docs/ERRATA.md` 持续追踪台账 | 协作 |
| 11-08 | 2.1 | Step 1（E-01/E-05/E-06 ✅，E-03 🟨）实测全绿；落地 Step 2（E-02 分级倾角保护待编译验收） | 协作 |
| 11-08 | 2.2 | Step 3（E-04 ✅）：地面站断连/切后台强制上锁归零、Mode-2->FRD 俯仰方向纠偏、防暴冲油门、仿真器 1:1 对齐及 Node 全链路单测全绿 | 协作 |
| 11-08 | 2.3 | 合并保留原中文稿中的复核命令/评分基线/详情条目，删除重复文件 `docs/纠错清单.md` | 协作 |
| 11-08 | 2.4 | 移动端地面站体验升级：用原生 `<dialog>` 修复设置弹窗无法退出缺陷；按手机触控极简诉求移除舵量/双微调按钮、隐藏无物理手柄时的油门切换项；修正摇杆视觉位移与手指 1:1 比例 | 协作 |
| 11-08 | 2.5 | Step 4（E-07 / E-03 / C-03 / C-04 🟨）：补齐 `config.h`、`mpu6050`、`motor_out`、`vbat`、`status_led`（WS2812 五态+校准灯语）、双核 `main.cpp`（400Hz `esp_timer` + 实测 `dt` 钳位）及全算法头文件单位注释 | 协作 |
| 11-08 | 2.6 | 本机 `gcc` 清理重编 7 套 C 单测与 2 套 Node 单测全绿通过，`E-02`、`C-04` 转 ✅；`E-07`/`E-03`/`C-03` 待 PlatformIO 编译及实机台架验收 | 协作 |
| 11-08 | 2.7 | 沉淀第 8 章《错题反思与工程实战经验总结》（坐标系契约、移动端防死锁、单向锁存与真断言哲学）；同步更新工作看板 | 协作 |
| 11-08 | 2.8 | ESP32-S3 交叉工具链拉取就绪，pio run -d firmware 一次编译成功生成 firmware.bin（RAM 14.0% / Flash 14.9%），E-07、E-03、C-03 全面转 ✅ 闭环 | 协作 |

---

## 8. 错题反思与工程实战经验总结（Lessons Learned）

> **导语**：每一次踩坑，都是物理规律对工程傲慢的严厉修正。以下提炼自本项目在全栈重构、审查与移动端实飞调试过程中的五大核心实战经验，作为团队后续软硬件开发、上板调参和版本迭代的避坑指南。

### 8.1 坐标系与符号链必须建立“端到端全链路契约”
- **原生传感器坐标不等于飞控坐标**：正面朝上贴装的 MPU6050 芯片物理原生输出为 **FLU（前左上）** 系，静止时测得的垂直支撑比力为 $+1g$。飞控算法统一以 **FRD（前右下）右手系**为唯一物理基准。**严禁直接把驱动层的原始读数裸传给姿态解算**，必须经过 `controller_map_flu_to_frd()` 转换（$a_{frd}.z = -a_{flu}.z$），否则加计与重力向量反相，滤波一开机即向倒扣发散。
- **人机操控习惯与动力学姿态的转换边界**：地面站或遥控手柄的航模美国手（Mode-2）习惯是“右摇杆前推向前方加速”，但这在飞行力学中对应的是**低头前飞（FRD 负俯仰，$-Pitch$）**。若遥控链路不假思索地把前推直传为 $+1000$，飞机起飞推杆就会瞬间仰头倒扣。输入合成层（`buildControlInput`）必须在最前端清晰划分职责边界，确保“操作直觉”与“物理定律”各司其职。
- **混控器必须推导力矩差动符号**：不能凭感觉写混控矩阵。必须紧扣物理力矩：Roll 右滚（$+Roll$）要求左侧电机（M3/M4）增速、右侧电机（M1/M2）减速；Pitch 抬头（$+Pitch$）要求前侧电机（M1/M4）增速、后侧电机（M2/M3）减速；Yaw 顺时针（$+Yaw$）要求逆时针桨（M1/M3, CCW）增速、顺时针桨（M2/M4, CW）减速。

---

### 8.2 移动端 Web 地面站的“人机交互与防死锁设计”
- **自遮挡浮层死锁陷阱**：在小屏手机上使用原生 CSS 浮动卡片或 `<details>` 标签展开高级设置时，浮动面板极易在高度超出视口时遮挡触发展开的 `<summary>` 按钮自身，导致“进得去出不来”。**正解是使用现代浏览器原生 `<dialog>` 元素**，配合全屏遮罩点击退出、ESC 键监听和显式关闭按钮，杜绝页面卡死。
- **相对位移触控（Relative Drag）与零阶跃防暴冲**：手机玻璃没有实体航模控的物理弹簧与阻尼。手指落下的瞬间，绝不能直接按触控点的绝对坐标计算油门，否则在悬停或低油门时手指重新触碰屏幕就会引发推力瞬间从 10% 跳变到 60% 导致暴冲炸机。**必须采用“落指处即原点”的相对位移机制**：按下时只记录锚点、拖拽时才累加位移，手指抬起重新按下时必须稳固锁存当前已有油门。
- **CSS `translate(%)` 相对位移陷阱**：在纯 CSS/JS 渲染摇杆滑块时，`transform: translate(x%, y%)` 中的百分比是**相对于滑块（Knob）自身尺寸**，而非外层底盘轨道直径。若滑块直径为轨道的 26%，位移就必须换算为 $135\%$ 左右，否则滑块只会在底盘中心微弱蠕动，造成手感严重粘滞。
- **界面极简主义才是最高安全性**：室外阳光下飞手心理极度紧张，繁复的舵量切换、双向微调在移动端不但没有实用价值，反而极易导致误触。将复杂配置沉淀到弹窗中，在未连接实体手柄时自动隐藏手柄油门切换，能最大限度降低人因失误。

---

### 8.3 安全状态机的“单向锁存”与“分级自稳”哲学
- **低压反弹陷阱与单向锁存（Sticky）**：1S 锂电池内阻较大，大油门机动时电池端电压被大电流压降拉低；一旦飞控收油门试图降落，放电电流骤降导致电压立即回弹到 3.5V 以上。若安全逻辑只写瞬态 `if (vbat < 3.3V)`，飞机会在空中陷入“低压降油门 → 电压回弹恢复大油门 → 再次低压”的往复振荡抽搐（发羊癫疯）。**正解是低压迫降（`LOWBAT_LAND`）必须设计为单向锁存状态**，一经触发，除非飞手主动拨动摇杆上锁归零，否则绝不自动退回正常飞行态；同时送入安全状态机的模拟量必须经过数字低通滤波（`vbat_filtered`），消除 20kHz 电机 PWM 开关毛刺。
- **瞬时阵风倾角与真倒扣的分级救机（E-02）**：单纯写 `tilt > 60° 立即断电` 是机械教条主义——户外一阵强侧风吹过，飞机倾角瞬时达到 62° 但机身姿态完全受控，此时直接切断电机只会让原本能自稳救回的飞机直接自由落体坠毁。**正解是分级保护**：
  - `>110°`（真倒扣）：单拍立即 `FAILSAFE` 断电停机，防止倒地后桨叶刮地烧毁 MOS 管或伤人；
  - `>60°`（大角度失稳）：摇杆指令强制归零，油门压低至悬停推力（40%），内环 PID 爆发出全部差动力矩全力回正机身；设置 45° 滞回退出角与 0.8 秒（320 拍）失控保护计时，超时无法自救才执行切电。
- **失联与切后台的绝对安全底线（E-04）**：手机切后台、来电弹窗、微信消息下拉、手柄蓝牙意外断连，若系统仅回中弹簧轴而不强制归零油门，如果飞机此前正处于 60% 油门推力，飞机将直接定速飞丢。**必须实施组合保护**：强制 `armed = false` + 油门归零 + 连发 3 帧急停帧，任何输入链路异常一律进入最高安全待命态。

---

### 8.4 测试哲学：向“假绿灯”和“凑参数过关”宣战
- **杜绝 Fake Green Tests**：没有任何断言、只在末尾 `printf("PASS\n")` 并无条件 `return 0` 的测试是工程自欺欺人。所有的测试用例必须内置带非零退出的 `CHECK(cond, msg)` 断言，并在编译阶段开启 `-Wall -Wextra -Werror=return-type`。当测试出现超调、发散或偏差时，**严禁通过盲目修改阈值或迁就测试数据来强行刷绿**，必须追查滤波器冷启动、积分累加边界与时序分频的真实根因。
- **桌面单测与交叉编译完全解耦**：核心算法头文件（LPF、Mahony、PID、混控、安全状态机）必须保持高移植性的纯 C 语言编写（无任何单片机专有库依赖）。这样在没有物理单片机硬件或交叉编译工具链尚未下完的情况下，也能在 PC 宿主机上 50 毫秒内完成全逻辑自动化验收，极大解放了敏捷迭代效率。

---

### 8.5 交叉编译环境与工程资产管理
- **本地庞大工具链与版本库严格隔离**：PlatformIO 下载的交叉编译器和官方 SDK（通常几百 MB）属于本地机器运行环境，必须放入 `.gitignore`。代码仓库只应当保留轻量纯净的配置文件（如锁定版本号 `espressif32@6.9.0` 的 `platformio.ini`）与业务源代码。
- **开发节奏不被环境安装卡脖子**：由于算法和协议已经在桌面测试矩阵中取得了真绿灯闭环，开发者完全可以先推进代码归档、文档撰写与物料采购，工具链下载完全可以后台异步进行，保持高效稳健的开发心流。
