jahjunn/esp32-micro-drone/firmware/src/flight/types.h

// 1. 头文件守卫：防止这个头文件被多个文件同时引用时造成“重复定义”报错
#pragma once

// 2. 引入 C 语言标准库中的基础类型：包含 uint8_t, int16_t, bool 等
#include <stdint.h>
#include <stdbool.h>

// ============================================================================
// 全仓统一坐标系与正方向契约（FRD 航空右手系，所有模块必须严格遵守）：
//   - 机体轴向：+X 朝机头正前，+Y 朝机身正右，+Z 朝机身正下
//   - 横滚 (Roll) ：绕 +X 轴旋转，机身向右倾斜为正 (+)
//   - 俯仰 (Pitch)：绕 +Y 轴旋转，机头向上翘起（抬头）为正 (+)
//   - 偏航 (Yaw)  ：绕 +Z 轴旋转，从上往下看顺时针（机头向右转）为正 (+)
// ============================================================================

// 3. 定义通用三维向量：
// 作用：打包 X, Y, Z 三个轴的数据，给传感器统一格式
//   - 用于陀螺仪时单位 [rad/s]；用于加速度计/比力时单位 [g]；用于磁力计时单位 [G]
typedef struct {
    float x; // X轴数值（FRD: 机头正前为 +）
    float y; // Y轴数值（FRD: 机身正右为 +）
    float z; // Z轴数值（FRD: 机身正下为 +）
} Vector3_t;

// 4. 定义姿态欧拉角：
// 作用：飞控经过数学姿态解算后输出的“机身倾角”（统一弧度制 [rad]）
typedef struct {
    float roll;      // 横滚角 [rad]：向右歪为正 (+)
    float pitch;     // 俯仰角 [rad]：机头翘起（抬头）为正 (+)
    float yaw;       // 航向角 [rad]：顺时针右转为正 (+)
} EulerAngle_t;

// 5. 定义遥控器指令帧：
// 作用：把手机/手柄发送过来的网络数据，打包转化为飞控理解的控制目标
typedef struct {
    float throttle;         // 油门归一化推力 [0.0, 1.0]（0.0 代表关机，1.0 代表 100% 满推力）
    float roll_target;      // 期望横滚角 [rad]：右倾为正 (+)
    float pitch_target;     // 期望俯仰角 [rad]：抬头为正 (+)
    float yaw_rate_target;  // 期望偏航角速度 [rad/s]：顺时针右转为正 (+)
    bool  armed;            // 安全锁：true=已解锁允许电机转；false=锁定，哪怕推油门也不转
} ControlCommand_t;

// 6. 定义电机混控输出：
// 作用：把姿态修正量分配后，最终下发给 4 个电机的 PWM 归一化占空比比例 [0.0, 1.0]
typedef struct {
    float m1; // 右前电机 (逆时针 CCW)，PWM 占空比 [0.0, 1.0]
    float m2; // 右后电机 (顺时针 CW)，PWM 占空比 [0.0, 1.0]
    float m3; // 左后电机 (逆时针 CCW)，PWM 占空比 [0.0, 1.0]
    float m4; // 左前电机 (顺时针 CW)，PWM 占空比 [0.0, 1.0]
} MotorOutput_t;
