jahjunn/esp32-micro-drone/(commit log)

2026-10-18 init: ESP32 + 有刷 8520 方案文档与板框
    [board_outline_v1.dxf, board_outline_v2.dxf, board_outline_v3.dxf, board_outline_v4.dxf, board_outline_v5.dxf, board_outline_v6.dxf, board_outline_v8.dxf]
2026-10-18 chore: 忽略 IDE 元数据 .codebuddy
2026-10-19 feat(firmware\test):飞控基础骨架、types定义与PID算法单元测试
2026-10-23 docs: 主控改为 ESP32-S3-N16R8，同步 BOM/架构/计划/README
2026-10-24 feat(flight): 添加 Quad-X 混控器算法与单元测试，更新开发板配置
2026-10-24 feat(drivers)+docs: 磁力计改为 QMC5883P（I2C 0x2C），新增驱动骨架
    - 型号 QMC5883L -> QMC5883P，I2C 地址 0x0D -> 0x2C；L 版库不兼容，必须按 P 版寄存器映射
    - 成本 ¥83/¥75 -> ¥78/¥70（README / BOM / WORKPLAN / ARCHITECTURE 同步）
    - 新增 firmware/src/drivers/qmc5883p.h / .cpp
    - 同步 README、BOM、ARCHITECTURE、DESIGN_FLOW、WORKPLAN
2026-10-24 docs(workplan): 更新软件部分(P2/P3/P4)当前开发进度
2026-10-24 docs(readme): 同步当前软件开发进度(P2-P4)
2026-10-24 docs: 统一 BOM 成本口径为 ¥78（板免费 ¥70）
    docs/BOM.md 合计为 78（板免费 70），但多处文档仍残留旧口径 74/66，
    导致同一份文档里成本数字互相矛盾。按 BOM 明细统一为 ¥78（板免费 ¥70）：
    - ARCHITECTURE.md §9.1：必购 ≈¥74 / 板免费 ≈¥66 → ≈¥78 / ≈¥70
    - DESIGN_FLOW.md P0 里程碑：BOM ≈¥74 → ≈¥78（板免费 ≈¥70）
    - WORKPLAN.md 进度看板 P0 行：BOM ≈¥74 → ≈¥78（板免费 ≈¥70）
    - WORKPLAN.md §13.3 变更记录：≈¥66–74 → ≈¥78（板免费 ≈¥70）
    口径依据：BOM 明细 24.25+6+3+12+3+1+1+12+3+8+5=78.25，扣板费 8 元为 70.25。
2026-10-28 feat(flight): 添加二阶巴特沃斯低通滤波器(biquad_lpf)与单元测试
2026-10-28 docs: 同步 P4-1 二阶巴特沃斯低通滤波器(biquad_lpf)完成进度
2026-10-30 feat(flight): 添加 Mahony 四元数姿态解算算法与单元测试
2026-10-30 docs: 同步 P4-2 Mahony 姿态解算完成进度
2026-11-01 feat(flight): 添加安全保护状态机(safety)与混控保均值抗饱和优化，同步P4进度
2026-11-01 feat(comm+controller): 新增机载BLE低延迟通信层与跨平台地面站手柄，同步P2-P6开发进度
2026-11-06 feat(flight): 完成400Hz/100Hz串级飞控总指挥与起飞前全链路安全加固
    1. 坐标与混控(types.h/mixer.h): 统一FRD右手系契约，修正Roll混控符号，新增12%电机怠速保底
    2. PID控制器(pid.h): 新增pid_reset、测量值微分防打杆尖峰、饱和条件抗积分风up
    3. 姿态解算与滤波(mahony.h/biquad_lpf.h): 新增0.5g~1.5g大机动防发散窗口、零偏限幅与首拍稳态预充电
    4. 安全状态机(safety.h): 新增3.30V低压迫降LOWBAT_LAND单向锁存，防减油门电压回弹抽搐
    5. 串级总指挥(controller.h): 集成NaN防火墙、200拍手抖检测陀螺仪校准、电压IIR滤波与地面怠速静默
    6. 地面站与工程规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
    [biquad_lpf.h, controller.h, mahony.h, mixer.h, pid.h, safety.h]
2026-11-08 feat: 完成第4步固件驱动与双核编排合拢、加固串级控制算法、升级移动端触屏地面站并归档介绍截图与避坑经验
2026-11-08 docs: 记录 PlatformIO 一键编译成功与 E-07/E-03/C-03 全绿验收
